hridhayesh09/rv32im-core/docs/results/board_2026-11-11.md

# Board run, 2026-11-11: CoreMark and the SDRAM burst fix

DE10-Lite, 50 MHz. Core with the default branch predictor (32-entry BTB, gshare with 256 counters,
4-entry return stack). CoreMark 1.0 from EEMBC (third_party/coremark), 2K performance run, port in
`sw/coremark`, GCC 13.2.0 `-O2 -ffreestanding -march=rv32im_zicsr_zifencei -mabi=ilp32`. Time is the
cycle counter; CoreMark picked 2000 iterations (over 10 s, so the runs are valid).

## CoreMark

| Build and placement | Iterations | Timed cycles | Time | CoreMark/MHz | CoreMark at 50 MHz | CPI | Mispredicted branches |
|---|---|---|---|---|---|---|---|
| Full SoC (NPU, no caches), program in on-chip RAM | 2000 | 741,126,904 | 14.82 s | **2.699** | 134.9 | 1.177 | 12.8 % |
| CPU-only (4 KB I$ + D$), program in on-chip RAM | 2000 | 741,126,904 | 14.82 s | **2.699** | 134.9 | 1.177 | 12.8 % |
| CPU-only (4 KB I$ + D$), program in SDRAM through the caches | 2000 | 751,703,684 | 15.03 s | **2.661** | 133.0 | 1.194 | 12.8 % |

CoreMark/MHz = iterations x 10^6 / cycles. CoreMark's own "Iterations/Sec" line divides by whole
seconds, so it rounds (142 and 133 instead of 134.9 and 133.0).

The two RAM runs took exactly the same number of cycles: the NPU and the caches don't touch a
program in on-chip RAM. From SDRAM, the 4 KB caches cost 1.4 % (10,576,780 cycles).

## SDRAM burst reads: found and fixed on the board

The first run of the cached build failed: the bootloader's LOAD of CoreMark into SDRAM was
rejected (`ERR crc`), and `sdram_test.bin` failed address lines, random words, bytes and copy
(simulation passed). The cached build moves 16-byte lines; the board had only ever run the
single-word path before.

1. The fitter report showed `DRAM_DQ[*]` with no input register in the I/O cell and a
   combinational fan-out of 8: each pin went straight into the 8-slot burst buffer, so the
   capture time depended on routing.
2. With a rising-edge I/O input register (`FAST_INPUT_REGISTER`) at 60 ns after READ:
   still failing, now everywhere.
3. A new diagnostic (`sw/soc/sdram_diag.c`, using a new uncached SDRAM window at 0x5000_0000)
   split the paths. Single words read back as their upper halfword twice (`9f379f37` for
   `9f3778b0`), and line reads returned correct halfwords shifted by one: writes were fine, reads
   were captured one cycle late.
4. Fix: the I/O input register clocked on the falling edge, 50 ns after READ, the middle of the
   window measured with edge-ml-accelerator/boardtest (clean from 50 to 70 ns). After that:

```
SDRAM diag
1 words: uncached write, uncached read: 0 errors
2 burst reads: uncached write, cached read: 0 errors
3 burst writes: cached write, uncached read: 0 errors
4 both: cached write, evict, cached read: 0 errors
DIAG PASS
```
```
SDRAM test
address lines: ok
random words: ok
bytes and halfwords: ok
copy: ok, write 2781 cycles, read 1318 cycles for 256 words
SDRAM PASS
```

## Full SoC after the fix (NPU, no caches; SDRAM over single-word accesses)

`sdram_test.bin`: `SDRAM PASS` (copy: write 2618 cycles, read 3648 cycles for 256 words).
The full-SoC CoreMark row above was measured again on this bitstream: 741,126,904 cycles, the same.

MNIST, the same 200 test images as on 2026-11-07 (`python tools/export_mnist.py 200`):

| | 2026-11-07 | 2026-11-11 (memory access from EX, branch predictor) |
|---|---|---|
| Software, cycles per image | 856,963 | 847,536 |
| NPU, cycles per image | 22,263 | 21,172 |
| Speedup | 38.49x | 40.03x |
| NPU correct | 199 / 200 | 199 / 200, all logits bit-exact |

```
build/mnist/mnist_blob.bin -> 0x40000000: sending 216896 bytes (18.8 s at 115200 baud)
build/sw/mnist.bin: sending 6688 bytes (0.6 s at 115200 baud)
board: OK, program running
starting program
MNIST on rv32im-core
software: 10 images, 10/10 correct, 847536 cycles per image (16950 us)
NPU:      200 images, 199/200 correct, 21172 cycles per image (423 us)
speedup: 40.03x
MNIST PASS: all logits bit-exact
DONE
```

## Doom

CPU-only build with the 8-bit VGA mode (320x200, 256 colours), 4 KB caches, the default branch
predictor: 14,059 LEs, 149 / 182 M9K, 55.11 MHz (slow 85C). doomgeneric + picolibc, GCC -O2,
everything in SDRAM; Freedoom Phase 1 (`freedoom1.wad`, 28,795,076 bytes) uploaded at 2 Mbaud
(`--fast 2000000`, 144 s). No sound.

Doom's own benchmark, `-timedemo demo1` (SW0 up): every game tic is drawn, as fast as possible.

```
timed 7117 gametics in 21254 realtics (11.719912 fps)
```

**11.7 frames per second** over the whole demo (607 s). The 5-second windows printed while it ran
ranged from 7.4 to 14.7 fps (116 windows after start-up).

```
switch to 2000000 baud: sending 0 bytes (0.0 s at 115200 baud)
build/sw/doom.bin -> 0x40000000: sending 406384 bytes (2.0 s at 2000000 baud)
build/doom/freedoom1.wad -> 0x42000000: sending 28795076 bytes (144.0 s at 2000000 baud)
build/sw/jump_to_sdram.bin: sending 8 bytes (0.0 s at 2000000 baud)
board: OK, program running
starting program
Doom on rv32im-core
WAD: 28795076 bytes, playing as freedoom1.wad
                           Doom Generic 0.1
Z_Init: Init zone memory allocation daemon. 
zone memory: 0x40449248, 600000 allocated for zone
Using . for configuration and saves
V_Init: allocate screens.
M_LoadDefaults: Load system defaults.
saving config in .default.cfg
W_Init: Init WADfiles.
 adding freedoom1.wad
 adding demo1.lmp
 couldn't open demo1.lmp
Playing demo demo1.lmp.
Using ./.savegame/ for savegames
===========================================================================
                           Freedoom: Phase 1
===========================================================================
 Doom Generic is free software, covered by the GNU General Public
 License.  There is NO warranty; not even for MERCHANTABILITY or FITNESS
 FOR A PARTICULAR PURPOSE. You are welcome to change and distribute
 copies under certain conditions. See the source for more information.
===========================================================================
 WARNING: You are playing using one of the Freedoom IWAD
 files, which might not work in this port. See this page
 for more information on how to play using Freedoom:
   http://www.chocolate-doom.org/wiki/index.php/Freedoom
===========================================================================
I_Init: Setting up machine state.
M_Init: Init miscellaneous info.
R_Init: Init DOOM refresh daemon - .......................................
P_Init: Init Playloop state.
S_Init: Setting up sound.
D_CheckNetGame: Checking network game status.
startskill 2  deathmatch: 0  startmap: 1  startepisode: 1
player 1 of 1 (1 nodes)
Emulating the behavior of the 'Ultimate Doom' executable.
HU_Init: Setting up heads up display.
ST_Init: Init status bar.
Freedoom: Phase 1
I_InitGraphics: framebuffer: x_res: 320, y_res: 200, x_virtual: 320, y_virtual: 200, bpp: 8
I_InitGraphics: framebuffer: RGBA: 0000, red_off: 0, green_off: 0, blue_off: 0, transp_off: 0
I_InitGraphics: DOOM screen size: w x h: 320 x 200
I_InitGraphics: Auto-scaling factor: 1
1 frames in 23468 ms: 0.0 fps
44 frames in 5052 ms: 8.7 fps
43 frames in 5055 ms: 8.5 fps
44 frames in 5023 ms: 8.7 fps
45 frames in 5058 ms: 8.8 fps
45 frames in 5058 ms: 8.8 fps
44 frames in 5028 ms: 8.7 fps
45 frames in 5026 ms: 8.9 fps
53 frames in 5066 ms: 10.4 fps
49 frames in 5059 ms: 9.6 fps
58 frames in 5030 ms: 11.5 fps
54 frames in 5013 ms: 10.7 fps
62 frames in 5048 ms: 12.2 fps
50 frames in 5067 ms: 9.8 fps
54 frames in 5000 ms: 10.8 fps
70 frames in 5065 ms: 13.8 fps
64 frames in 5067 ms: 12.6 fps
59 frames in 5102 ms: 11.5 fps
62 frames in 5024 ms: 12.3 fps
65 frames in 5069 ms: 12.8 fps
48 frames in 5045 ms: 9.5 fps
43 frames in 5109 ms: 8.4 fps
56 frames in 5056 ms: 11.0 fps
69 frames in 5079 ms: 13.5 fps
46 frames in 5021 ms: 9.1 fps
55 frames in 5088 ms: 10.8 fps
60 frames in 5013 ms: 11.9 fps
63 frames in 5000 ms: 12.6 fps
58 frames in 5040 ms: 11.5 fps
63 frames in 5056 ms: 12.4 fps
67 frames in 5052 ms: 13.2 fps
57 frames in 5069 ms: 11.2 fps
61 frames in 5060 ms: 12.0 fps
54 frames in 5001 ms: 10.7 fps
60 frames in 5003 ms: 11.9 fps
59 frames in 5032 ms: 11.7 fps
51 frames in 5047 ms: 10.1 fps
60 frames in 5028 ms: 11.9 fps
60 frames in 5012 ms: 11.9 fps
57 frames in 5074 ms: 11.2 fps
63 frames in 5034 ms: 12.5 fps
61 frames in 5063 ms: 12.0 fps
59 frames in 5023 ms: 11.7 fps
59 frames in 5059 ms: 11.6 fps
63 frames in 5079 ms: 12.4 fps
62 frames in 5028 ms: 12.3 fps
66 frames in 5070 ms: 13.0 fps
62 frames in 5003 ms: 12.3 fps
68 frames in 5002 ms: 13.5 fps
66 frames in 5040 ms: 13.0 fps
59 frames in 5044 ms: 11.6 fps
61 frames in 5065 ms: 12.0 fps
62 frames in 5066 ms: 12.2 fps
68 frames in 5069 ms: 13.4 fps
68 frames in 5069 ms: 13.4 fps
66 frames in 5007 ms: 13.1 fps
60 frames in 5025 ms: 11.9 fps
61 frames in 5064 ms: 12.0 fps
65 frames in 5033 ms: 12.9 fps
64 frames in 5002 ms: 12.7 fps
69 frames in 5026 ms: 13.7 fps
60 frames in 5013 ms: 11.9 fps
60 frames in 5041 ms: 11.9 fps
62 frames in 5052 ms: 12.2 fps
64 frames in 5065 ms: 12.6 fps
61 frames in 5005 ms: 12.1 fps
65 frames in 5049 ms: 12.8 fps
65 frames in 5026 ms: 12.9 fps
65 frames in 5050 ms: 12.8 fps
70 frames in 5000 ms: 14.0 fps
70 frames in 5044 ms: 13.8 fps
71 frames in 5054 ms: 14.0 fps
71 frames in 5039 ms: 14.0 fps
58 frames in 5012 ms: 11.5 fps
64 frames in 5001 ms: 12.7 fps
68 frames in 5040 ms: 13.4 fps
74 frames in 5033 ms: 14.7 fps
68 frames in 5097 ms: 13.3 fps
42 frames in 5026 ms: 8.3 fps
61 frames in 5071 ms: 12.0 fps
57 frames in 5038 ms: 11.3 fps
42 frames in 5073 ms: 8.2 fps
67 frames in 5048 ms: 13.2 fps
38 frames in 5096 ms: 7.4 fps
44 frames in 5055 ms: 8.7 fps
68 frames in 5037 ms: 13.5 fps
64 frames in 5041 ms: 12.6 fps
55 frames in 5056 ms: 10.8 fps
64 frames in 5018 ms: 12.7 fps
67 frames in 5072 ms: 13.2 fps
64 frames in 5009 ms: 12.7 fps
60 frames in 5039 ms: 11.9 fps
63 frames in 5039 ms: 12.5 fps
59 frames in 5023 ms: 11.7 fps
53 frames in 5091 ms: 10.4 fps
56 frames in 5069 ms: 11.0 fps
58 frames in 5058 ms: 11.4 fps
58 frames in 5054 ms: 11.4 fps
64 frames in 5006 ms: 12.7 fps
66 frames in 5046 ms: 13.0 fps
65 frames in 5069 ms: 12.8 fps
64 frames in 5030 ms: 12.7 fps
62 frames in 5063 ms: 12.2 fps
65 frames in 5030 ms: 12.9 fps
51 frames in 5027 ms: 10.1 fps
53 frames in 5043 ms: 10.5 fps
48 frames in 5015 ms: 9.5 fps
55 frames in 5077 ms: 10.8 fps
52 frames in 5020 ms: 10.3 fps
58 frames in 5052 ms: 11.4 fps
72 frames in 5061 ms: 14.2 fps
67 frames in 5008 ms: 13.3 fps
58 frames in 5020 ms: 11.5 fps
61 frames in 5023 ms: 12.1 fps
63 frames in 5021 ms: 12.5 fps
68 frames in 5035 ms: 13.5 fps
61 frames in 5016 ms: 12.1 fps
timed 7117 gametics in 21254 realtics (11.719912 fps)
Doom exited (-1)
DONE
```

### Playing

With SW0 down Doom starts normally; `tools/doom_keys.py` sent the laptop's key presses over the
serial port (2 Mbaud), and the game was played on the VGA monitor: menus, a new game, moving,
firing and opening doors all respond.

## Raw CoreMark output

Full SoC, on-chip RAM:
```
build/sw/coremark_ram.bin: sending 12836 bytes (1.1 s at 115200 baud)
board: OK, program running
starting program
2K performance run parameters for coremark.
CoreMark Size    : 666
Total ticks      : 741126904
Total time (secs): 14
Iterations/Sec   : 142
Iterations       : 2000
Compiler version : GCC13.2.0
Compiler flags   : -O2 -ffreestanding -march=rv32im_zicsr_zifencei -mabi=ilp32
Memory location  : on-chip RAM
seedcrc          : 0xe9f5
[0]crclist       : 0xe714
[0]crcmatrix     : 0x1fd7
[0]crcstate      : 0x8e3a
[0]crcfinal      : 0x4983
Correct operation validated. See README.md for run and reporting rules.
Timed cycles     : 741126904
Timed instret    : 629675770
Timed branches   : 129600633
Timed mispredicts: 16604473
COREMARK DONE
```
CPU-only, on-chip RAM:
```
build/sw/coremark_ram.bin: sending 12836 bytes (1.1 s at 115200 baud)
board: OK, program running
starting program
2K performance run parameters for coremark.
CoreMark Size    : 666
Total ticks      : 741126904
Total time (secs): 14
Iterations/Sec   : 142
Iterations       : 2000
Compiler version : GCC13.2.0
Compiler flags   : -O2 -ffreestanding -march=rv32im_zicsr_zifencei -mabi=ilp32
Memory location  : on-chip RAM
seedcrc          : 0xe9f5
[0]crclist       : 0xe714
[0]crcmatrix     : 0x1fd7
[0]crcstate      : 0x8e3a
[0]crcfinal      : 0x4983
Correct operation validated. See README.md for run and reporting rules.
Timed cycles     : 741126904
Timed instret    : 629675770
Timed branches   : 129600633
Timed mispredicts: 16604473
COREMARK DONE
```
CPU-only, SDRAM through the caches:
```
build/sw/coremark_sdram.bin -> 0x40000000: sending 12844 bytes (1.1 s at 115200 baud)
build/sw/jump_to_sdram.bin: sending 8 bytes (0.0 s at 115200 baud)
board: OK, program running
starting program
2K performance run parameters for coremark.
CoreMark Size    : 666
Total ticks      : 751703684
Total time (secs): 15
Iterations/Sec   : 133
Iterations       : 2000
Compiler version : GCC13.2.0
Compiler flags   : -O2 -ffreestanding -march=rv32im_zicsr_zifencei -mabi=ilp32
Memory location  : SDRAM via caches
seedcrc          : 0xe9f5
[0]crclist       : 0xe714
[0]crcmatrix     : 0x1fd7
[0]crcstate      : 0x8e3a
[0]crcfinal      : 0x4983
Correct operation validated. See README.md for run and reporting rules.
Timed cycles     : 751703684
Timed instret    : 629675770
Timed branches   : 129600633
Timed mispredicts: 16604473
COREMARK DONE
```
