hridhayesh09/rv32im-core/docs/results/board_2026-11-07.md

# Board results, 2026-11-07

DE10-Lite (10M50DAF484C7G), 50 MHz, FPGA image from fpga/de10lite (Quartus Prime Lite 25.1:
31,762 LEs, 165/182 M9K, 136 multipliers, +2.103 ns setup slack at 50 MHz). UART through the
ESP32-S3's CH343 USB-serial chip (ESP32 held in reset) on COM8, 115200 baud. Commands from
docs/board_bringup.md; output copied as printed, except that the hello log's doubled blank
lines (a display bug in the first version of upload.py on Windows, since fixed) are removed.

## Bootloader banner (after programming the FPGA)

```
rv32im-core bootloader
ready
```

## tools/upload.py COM8 build/sw/hello.bin --until DONE

```
sending 3808 bytes (0.3 s at 115200 baud)
board: OK, program running
starting program
Hello from rv32im-core!
fib(30) = 832040, 233 cycles
switches = 0x3ff
printf check: [  -42] [  7] [0000beef] [ok] [Z] [%]
DONE

```

## tools/upload.py COM8 build/sw/sdram_test.bin --until DONE

```
sending 4600 bytes (0.4 s at 115200 baud)
board: OK, program running

starting program
SDRAM test
address lines: ok
random words: ok
bytes and halfwords: ok
copy: ok, write 3109 cycles, read 3907 cycles for 256 words
SDRAM PASS
DONE
```

## tools/upload.py COM8 build/sw/mnist.bin --data 0x40000000 build/mnist/mnist_blob.bin --until DONE

```
C:\Users\hridh\rv32im-core\build\mnist\mnist_blob.bin -> 0x40000000: sending 216896 bytes (18.8 s at 115200 baud)
C:\Users\hridh\rv32im-core\build\sw\mnist.bin: sending 6624 bytes (0.6 s at 115200 baud)
board: OK, program running

starting program
MNIST on rv32im-core
software: 10 images, 10/10 correct, 856963 cycles per image (17139 us)
NPU:      200 images, 199/200 correct, 22263 cycles per image (445 us)
speedup: 38.49x
MNIST PASS: all logits bit-exact
DONE
```

## VGA and Snake, 2026-11-10

Same FPGA image, VGA monitor on the DE10-Lite's VGA connector. `tools/upload.py COM8 build/sw/snake.bin`:

```
C:\Users\hridh\rv32im-core\build\sw\snake.bin: sending 6140 bytes (0.5 s at 115200 baud)
board: OK, program running

starting program
SNAKE ready
```

On the monitor: the SNAKE title screen (checked by eye; first time the VGA output was seen on a
real monitor). Then played: KEY0/KEY1 steer the snake, the score updates on the monitor and the
7-segment displays, game over and restart work.
