hridhayesh09/rv32im-core/docs/results/quartus_sweep_2026-11-11.csv

config | LEs | M9K | Fmax_MHz | setup_slack_ns
nobp | 12402 | 147 | 54.06 | 1.502
bimodal | 13597 | 149 | 54.04 | 1.495
gshare | 13701 | 149 | 50.4 | 0.157
gshare-ras | 14059 | 149 | 55.11 | 1.854
btb16 | 13949 | 149 | 54.25 | 1.568
btb64 | 14070 | 149 | 52.85 | 1.079
bht1k | 16514 | 149 | 55.37 | 1.940
1k-dm | 12111 | 149 | 53.81 | 1.417
2k-dm | 12815 | 149 | 54.0 | 1.483
8k-dm | 16635 | 158 | 54.49 | 1.648
1k-2way | 12646 | 159 | 51.86 | 0.718
4k-2way | 14928 | 159 | 49.34 | -0.269
