hridhayesh09/rv32im-core/tb/tb_top.sv

// Simulation top: the core with one dual-port RAM for code and data (as in the SoC), loaded
// from a program image (+program=<hex file>). The retire trace is brought out as ports.
//
// +random_stalls makes data accesses take a random number of extra cycles (like a slow bus
// device), to test the core's wait-state handling with every program.
// The branch predictor configuration is a parameter (defaults: the core's).
module tb_top #(
    parameter int BP_MODE   = 2,
    parameter int BTB_BITS  = 5,
    parameter int BHT_BITS  = 8,
    parameter int RAS_DEPTH = 4
) (
    input  logic        clk,
    input  logic        rst,
    output logic        rvfi_valid,
    output logic [31:0] rvfi_pc,
    output logic [31:0] rvfi_insn,
    output logic [4:0]  rvfi_rd,
    output logic [31:0] rvfi_rd_wdata,
    output logic        rvfi_mem_read,
    output logic [3:0]  rvfi_mem_wmask,
    output logic [31:0] rvfi_mem_addr,
    output logic [31:0] rvfi_mem_wdata
);
    logic        imem_en, dmem_en, dmem_stall;
    logic [3:0]  mem_events;
    logic        imem_stall, fetch_valid, cache_flush;
    assign mem_events = 4'b0000;   // no caches here
    assign imem_stall = 1'b0;
    /* verilator lint_off UNUSEDSIGNAL */
    logic unused_core_outputs;
    assign unused_core_outputs = fetch_valid ^ cache_flush;
    /* verilator lint_on UNUSEDSIGNAL */
    logic [3:0]  dmem_we;
    logic [31:0] imem_addr, imem_rdata, dmem_addr, dmem_wdata, dmem_rdata;

    core #(.BP_MODE(BP_MODE), .BTB_BITS(BTB_BITS), .BHT_BITS(BHT_BITS), .RAS_DEPTH(RAS_DEPTH))
        u_core (.*);

    dpram #(.INIT_PLUSARG("program")) u_ram (
        .clk     (clk),
        .a_en    (imem_en),
        .a_addr  (imem_addr),
        .a_rdata (imem_rdata),
        .b_en    (dmem_en),
        .b_we    (dmem_we),
        .b_addr  (dmem_addr),
        .b_wdata (dmem_wdata),
        .b_rdata (dmem_rdata)
    );

    // Random wait states. `pending`: a data access was sent and its instruction is now in WB.
    // While it is pending, each cycle a pseudo-random bit decides whether the data is late.
    // The RAM isn't enabled during a stall, so its output holds the right data.
    logic        random_stalls, pending;
    logic [15:0] lfsr;

    initial random_stalls = $test$plusargs("random_stalls");

    always_ff @(posedge clk) begin
        if (rst) begin
            pending <= 1'b0;
            lfsr    <= 16'hACE1;
        end else begin
            if (!dmem_stall) pending <= dmem_en;
            lfsr <= {lfsr[14:0], lfsr[15] ^ lfsr[13] ^ lfsr[12] ^ lfsr[10]};
        end
    end

    assign dmem_stall = random_stalls && pending && lfsr[0];
endmodule
