hridhayesh09/rv32im-core/rtl/alu.sv

// Arithmetic logic unit: the 10 RV32I integer operations, purely combinational.
// Shifts use only b[4:0], as the ISA specifies.
module alu
    import rv_pkg::*;
(
    input  logic [31:0] a,
    input  logic [31:0] b,
    input  alu_op_t     op,
    output logic [31:0] y
);
    always_comb begin
        case (op)
            ALU_ADD:  y = a + b;
            ALU_SUB:  y = a - b;
            ALU_SLL:  y = a << b[4:0];
            ALU_SLT:  y = {31'b0, $signed(a) < $signed(b)};
            ALU_SLTU: y = {31'b0, a < b};
            ALU_XOR:  y = a ^ b;
            ALU_SRL:  y = a >> b[4:0];
            ALU_SRA:  y = $unsigned($signed(a) >>> b[4:0]);
            ALU_OR:   y = a | b;
            ALU_AND:  y = a & b;
            default:  y = '0;
        endcase
    end
endmodule
