hridhayesh09/rv32im-core/(commit log)

2026-11-06 Stage 0: repo skeleton, setup guide, Verilator+cocotb smoke test, CI
    Adds the roadmap, setup guide and first notes, make check-tools, an 8-bit counter smoke test checked against a Python model every cycle, and a GitHub Actions workflow that builds and caches Verilator v5.036 and Spike.
2026-11-06 Stage 1 step 1: ALU, register file and decoder with cocotb tests
    ALU: 10 RV32I operations, checked on all boundary-value pairs and 20,000 random cases. Register file: x0 hardwired, write-before-read bypass, 20,000 random cycles against a model. Decoder: all RV32I formats, control signals and illegal-instruction detection, checked with a separate Python encoder (20,000 instructions, immediate extremes, 40,000 random/mutated words). Verilator -Wall is clean. Notes explain each block with interview questions.
2026-11-06 Stage 1 step 2: 5-stage pipeline with branch flush, checked in lockstep with Spike
    IF/ID/EX/MEM/WB with synchronous-read memories, branches and jumps resolved in EX with a 2-instruction flush, and a retire trace. Every instruction of each test program is compared with Spike's commit log (PC, instruction, register write, memory access). Three programs (ALU, loads/stores, control flow) space out dependent instructions because forwarding comes next.
    [core.sv, tb_top.sv]
2026-11-06 Stage 1 step 3: forwarding from MEM and WB into EX
    Operands are taken from the newest in-flight producer (MEM, then WB), with the register file bypass covering distance 3. New forwarding.S runs back-to-back dependencies on ALU ops, stores (address and data), loads used two later, branches, JALR, AUIPC and JAL, and checks that writes to x0 are never forwarded; all match Spike.
2026-11-06 Stage 1 step 4: load-use stall
    When the instruction in ID reads the destination of a load in EX, IF and ID hold for one cycle and a bubble enters EX; WB forwarding then supplies the loaded value. New load_use.S covers every load size, rs1/rs2/store/branch/JALR consumers, pointer chasing, and cases that must not stall; all match Spike. Clearer error when Spike never finishes.
    [core.sv]
2026-11-06 Notes on the pipeline, flush, forwarding and load-use stall; roadmap and README status
    Lockstep and branch flush moved into step 2 so every later step is checked against Spike.
2026-11-06 Stage 1 step 6: official riscv-tests rv32ui in lockstep with Spike
    Adds riscv-tests as a submodule and a minimal riscv_test.h (clear registers, report through tohost). 40 of 42 rv32ui tests pass with every retired instruction matching Spike (13,107 instructions). fence_i (needs FENCE.I with split memories) and ma_data (misaligned access) are excluded with the reason shown in test output. The core build and lockstep runner are now shared by all core-level tests.
2026-11-06 Stage 1 step 8: random instruction tests in lockstep with Spike
    Generator of random RV32I programs (random register values, ALU, loads/stores of every size, forward branches and jumps, counted loops, a small hot register set for dense hazards), each checked instruction by instruction against Spike. CI runs 20 seeds (9,296 instructions); a local 300-seed run compared 140,187 instructions with no mismatch.
2026-11-06 Stage 1 step 9: M extension (multiply and divide)
    Multi-cycle muldiv unit: 2-cycle multiply with registered operands, 33-cycle restoring divider with sign fix-up; EX stalls until done. Decoder accepts the M encodings. All 8 rv32um tests pass in lockstep with Spike, plus a directed muldiv.S and M instructions in the random programs (300 seeds: 140,887 instructions, 6,667 multiply/divide). Measured cost: 2 extra cycles per MUL, 33 per DIVU.
    [core.sv, decoder.sv, muldiv.sv, test_decoder.py, test_muldiv.py]
2026-11-06 Stage 1 step 10: C programs, plus README diagram and results
    crt0.S (clear registers, stack, zero .bss, call main, report through tohost) and a linker script with .bss and stack symbols. fib, sort and primes compile with GCC -O2 and pass in lockstep with Spike; the test reports instructions, cycles and CPI (1.152, 1.298 and 6.977). README now has the pipeline diagram and a results table with numbers from make test.
2026-11-06 README: pipeline diagram and Stage 1 results table
    The previous commit's message mentioned these but the README change didn't make it in.
2026-11-06 Stage 2 plan: memory map and design decisions; CI job timeout
2026-11-06 Stage 2 step 1: wait states on the data port
    New dmem_stall input freezes the whole pipeline while the instruction in WB waits for slow data; requests are sent only once, and the muldiv unit holds its result until taken. tb_top can inject random wait states (+random_stalls); all directed, riscv-tests, C and 10 random programs pass in lockstep with them (e.g. sort 38,312 -> 44,377 cycles). 149 tests pass.
2026-11-06 Stage 2 step 2: Wishbone UART, timer and GPIO
    UART (8N1, programmable divisor, 2-flop RX synchronizer, mid-bit sampling, overrun flag), 64-bit cycle timer with compare and CLK_HZ, and GPIO for the DE10-Lite LEDs, switches, buttons and six 7-segment displays. Each is a Wishbone slave with a registered ack, tested with a small Wishbone master in cocotb (7 tests).
2026-11-06 Shared dual-port RAM for code and data; FENCE.I
    dpram replaces the separate instruction/data RAMs (as in the SoC). FENCE.I redirects to PC+4 so instructions fetched before a store to code are refetched. The official fence_i test now passes (41/42 rv32ui); a new directed fence_i.S patches the very next instruction and fails without the flush.
    [core.sv, decoder.sv, dpram.sv, tb_top.sv, test_decoder.py]
2026-11-06 Stage 2 step 3: the SoC
    soc.sv: core, 8 KB boot ROM and 64 KB RAM as tightly coupled dual-port memories, a Wishbone bridge that freezes the core during bus accesses, and an interconnect with UART, timer, GPIO and a default slave. C driver library (UART, printf, timer, 7-segment) and a hello program; the SoC simulation boots from ROM, runs it from RAM and checks the UART text, LEDs and displays.
    [hello.c, soc.sv]
2026-11-06 Stage 2 step 4: SDRAM controller
    Closed-page controller for the IS42S16320 (burst of 2 halfwords per word, CAS 2, auto-precharge, refresh every 380 cycles, full power-up sequence) on the Wishbone bus at 0x4000_0000. A chip model checks every timing/protocol rule; it found a power-up bug (all-zero command register = LOAD MODE), fixed with a NOP power-up value. Unit test: 3,000 random accesses, 0 violations. SoC test: C memory test passes, 256-word copy 2,855 cycles write / 3,615 read.
    [sdram_ctrl.sv, sdram_model.sv, sdram_test.c, soc.sv, tb_sdram.sv, tb_soc.sv, test_sdram.py]
2026-11-06 Stage 2 step 5: UART bootloader
    Boot ROM bootloader (996 bytes): receives BOOT + length + program + CRC-32 into on-chip RAM, checks the CRC, fence.i, and jumps; 'R' reruns the program in RAM. tools/upload.py sends a program and shows its output; make sw builds the boot ROM image and uploadable programs. SoC test: a corrupted upload is rejected with ERR crc, then the real 2,708-byte program runs.
2026-11-06 Stage 2 step 6: DE10-Lite build
    Board top level, pins and SDRAM clocking reused from the board-tested edge-ml-accelerator/boardtest. Fixes found by the first Quartus compile: unsupported SystemVerilog (inside, size casts, a field named like a module), a register file Quartus considered unused, memories not mapped to block RAM (now altsyncram true dual-port for the FPGA, behavioural model in simulation, boot ROM as .mif), and a near-zero timing margin (slave decode now registered). Result: 4,626 LEs (9%), 589,824 memory bits (35%), 8 multipliers, Fmax 55.17 MHz at slow 85C, +1.875 ns setup slack at 50 MHz. Adds the board bring-up checklist and film list.
    [build_sw.py, core.sv, de10lite_top.sv, decoder.sv, dpram.sv, regfile.sv, sdram_ctrl.sv]
2026-11-06 Stage 3 plan: on-chip 320x240 4-bit framebuffer, and its consequence for Stage 4's block RAM budget
2026-11-06 Stage 3 step 1: VGA display with a 320x240, 16-colour framebuffer
    wb_vga: 640x480@60 timing from a 25 MHz pixel enable, framebuffer pixels doubled in both directions, 16-entry programmable palette, vblank status and frame counter. fb_ram: 4-bit true dual-port (altsyncram on the FPGA). A simulated monitor (tb/vga_capture.sv) locks onto the sync pulses, checks every timing number and saves frames as PPM; tools/ppm.py converts to PNG. Unit test: written pixels and a palette change appear as the right 2x2 blocks on screen, 0 timing errors.
    [fb_ram.sv, ppm.py, sim.py, tb_vga.sv, test_vga.py, vga_capture.sv, wb_vga.sv]
2026-11-06 Stage 3 steps 2-4: VGA in the SoC, graphics driver, Snake
    The VGA block is on the bus (registers at 0x1000_3000, framebuffer at 0x2000_0000) and the SoC simulation includes the simulated monitor. sw/lib/gfx.c: pixels, rectangles, 5x7 text, palette, vblank wait. sw/soc/snake.c: Snake with KEY0/KEY1 or W/A/S/D, score on screen, 7-segment and UART. The SoC test plays a game (start, turn, crash), checks every move and the captured picture; screenshots in docs/images from those runs. 163 tests pass.
    [snake.c, soc.sv, tb_soc.sv]
2026-11-06 Stage 3 step 5: VGA on the DE10-Lite build, board checklist and film list
    VGA pins from the boardtest pin list. Quartus: 5,197 LEs (10%), 110/182 M9K (72 SoC + 38 framebuffer, as planned), Fmax 52.63 MHz at slow 85C, +1.001 ns setup slack at 50 MHz. README shows the Snake screenshot from simulation.
2026-11-06 Stage 4 plan: memory-mapped NPU with local buffers, weights in SDRAM, block RAM and DSP budget
2026-11-06 Stage 4 step 1: NPU block around the 16x16 systolic array
    wb_npu: weight tile loading (one PE row per 4 writes), a 1024-row activation buffer and a 256-row int32 result buffer (simple dual-port M9K style from edge-ml-accelerator), and a sequencer that streams COUNT rows at one per clock with base/stride addressing and an accumulate mode. systolic_array.v and pe.v copied unchanged from edge-ml-accelerator. Unit tests against NumPy: one tile with extreme values, K accumulation over 3 tiles, 6 random products; 20 rows take 52 cycles.
2026-11-07 Stage 4 steps 2-4: NPU in the SoC, MNIST software vs NPU (bit-exact)
    NPU on the bus (registers 0x1000_4000, buffers 0x3000_0000). Model + 200 test images in sw/mnist (from edge-ml-accelerator), tools/export_mnist.py packs them with NumPy reference logits for SDRAM; the SDRAM model can preload it in simulation. sw/soc/mnist.c runs the network in software and on the NPU and checks every logit. Simulation: software 700,853 cycles/image, NPU 22,179, speedup 31.59x, all bit-exact. First full Quartus fit with the 16x16 array: 31,903 LEs (64%), 165/182 M9K, 136 multipliers, but -0.127 ns setup slack; bus read data and the stall are now registered in the bridge to fix that (Quartus not rerun yet).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
    [export_mnist.py, make_mnist_data.py, mnist.c, sdram_model.sv, soc.sv]
2026-11-07 First board run: bootloader, SDRAM and MNIST on the DE10-Lite
    On the board: bootloader banner, hello, the 64 MB SDRAM test, and MNIST with the model in SDRAM: software 856,963 cycles/image, NPU 22,263 (38.49x), 199/200 correct, every logit bit-exact with NumPy. Logs in docs/results/board_2026-11-07.md. Bootloader LOAD command (data to SDRAM or free RAM) with a simulation test; the bootloader waits for SDRAM init before 'ready' so LOAD can't lose bytes. upload.py --data and Windows line endings. Timing with the NPU: +2.103 ns at 50 MHz after registering bus read data. 166 tests pass.
    [bootloader.c, loadcheck.c, upload.py]
2026-11-11 Fix a code fence in the board log
2026-11-11 Snake played on the board: buttons, VGA and 7-segment score work
2026-11-11 Roadmap: Stage 5 (exceptions, counters, caches, branch prediction, CoreMark), Doom, Stage 6 (OpenLane)
2026-11-11 Stage 5 step 1: exceptions and CSRs; rv32ui 42/42
    Machine-mode CSRs (mstatus, misa, mie/mip, mtvec, mscratch, mepc, mcause, mtval, mcycle, minstret and the read-only aliases), the six CSR instructions and MRET. Precise exceptions taken in EX for illegal instructions, ECALL, EBREAK and misaligned loads, stores and jump targets. minstret reads include the older instructions still in MEM/WB so values match Spike. The riscv-tests environment emulates misaligned accesses in a trap handler, so ma_data passes (8,393 instructions in lockstep with Spike, run with --priv=m). New directed traps.S. 170 tests pass, none skipped.
    [core.sv, csr.sv, decoder.sv, soc.sv]
2026-11-11 Stage 5 step 2: performance counters
    mhpmcounter3-11 (and read-only hpmcounter copies): branches, mispredicts, load-use stall cycles, mul/div wait, memory wait, and four inputs for cache accesses/misses. sw/lib/perf.h reads them from C (with a memory clobber). perf_test.c checks exact counts in the SoC simulation: 100 branches / 99 mispredicts, 50 load-use stalls, 33 cycles per divide, 2 per multiply, 2 per bus read. 171 tests pass.
    [core.sv, csr.sv, perf_test.c, soc.sv, tb_top.sv]
2026-11-11 SoC: mark the SDRAM line port outputs as intentionally unconnected (fixes the SoC build)
    [soc.sv]
2026-11-11 Stage 5 steps 3-5: instruction and data caches
    cache.sv: direct-mapped or 2-way LRU, 16-byte lines, block-RAM tags/data with flip-flop valid/dirty/LRU bits, same hit timing as plain block RAM; misses freeze the pipeline while a dirty victim is written back, the line refilled and the lookup replayed. Data cache is write-back, write-allocate, with store forwarding (also into victim lines). FENCE.I writes back the D-cache and invalidates the I-cache. Core: imem_stall, fetch_valid, cache_flush; cache events feed mhpmcounter8-11. tb_cached runs every lockstep test through 256-byte DM and 2-way caches with random memory latency: 142 runs match Spike. Planted bugs caught. 314 tests pass.
    [cache.sv, cache_ram.sv, core.sv, line_mem.sv, mem_arbiter.sv, soc.sv, tb_cached.sv, tb_top.sv]
2026-11-11 Caches in the SoC, CPU-only build, and an earlier memory stage for timing
    - soc.sv: optional I-cache and D-cache in front of SDRAM (0x4xxxxxxx), sharing
    the SDRAM line port through the arbiter; NPU can be left out.
    - rv32im_cpu revision: CPU-only build with 4 KB caches.
    - core.sv: loads and stores are sent from EX (address straight from the ALU),
    and the loaded value is aligned and registered in MEM, so WB forwards only
    registered values. CPU-only build: 46.91 -> 55.63 MHz; full build with NPU:
    55.88 -> 56.76 MHz.
    - cache_test.c runs from SDRAM through the caches; tests for it and the counters.
2026-11-11 CoreMark on the board, and SDRAM burst reads fixed on hardware
    - CoreMark 1.0 (EEMBC, submodule) with a port in sw/coremark: 2.699
    CoreMark/MHz from on-chip RAM, 2.661 from SDRAM through 4 KB caches
    (2000 iterations, ~15 s, validated); simulation test checks the CRCs.
    - SDRAM: the cached build's line reads failed on the board. Read data is now
    captured by a falling-edge register in the I/O cell, 50 ns after READ (the
    middle of the window measured with boardtest). Uncached SDRAM window at
    0x5000_0000 and sw/soc/sdram_diag.c to test words, burst reads and burst
    writes separately.
    - MNIST rerun on the board: 40.03x (software 847,536 cycles, NPU 21,172).
    - Cache and predictor paramet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
    [build_sw.py, coremark_sweep.py, de10lite_top.sv, export_mnist.py, quartus_sweep.py]
2026-11-11 Doom runs on the board: 11.7 fps in the timedemo
    - doomgeneric (submodule) with picolibc: sw/doom provides the platform layer
    (frame, clock, keys) and the system calls; the WAD is read from SDRAM.
    tools/build_doom.py builds it with picolibc's start-up code and linker script.
    - VGA 8-bit mode for the CPU-only build: 320x200, 256-entry palette, 32-bit
    writes into a simple dual-port framebuffer (fb8_ram), shown with black bars.
    - UART: 64-byte receive FIFO. Bootloader: BAUD command (2 Mbaud uploads) and a
    table CRC. upload.py --fast, tools/doom_keys.py for keyboard input.
    - Freedoom Phase 1, -timedemo demo1 on the DE10-Lite: 7117 tics in 607 s,
    11.7 fps. CPU-only build: 14,059 LEs, 14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
2026-11-11 Doom: keyboard play tested on the board
2026-11-11 Stage 6 ready to run: ASIC top level, OpenLane 2 flow, gate-level test
    - rtl/rv32im_asic.sv: core + 256-byte I$/D$ + arbiter, one line port and the
    retire trace. tb_cached is now this module plus the line memory, so all
    cached lockstep tests run on exactly what goes into the flow.
    - cache_ram.sv: flip-flop RAM when ASIC is defined (block RAM on the FPGA).
    - asic/run_flow.sh (sv2v, then OpenLane 2, Sky130A, 20 ns), asic/config.json,
    tools/asic_report.py, tests/core/test_gate_level.py (riscv-tests on the
    final netlist in Icarus, skipped until a netlist exists), docs/asic.md.
    - quartus_sweep.py: start every build from an empty Quartus database (it was
    reusing a stale branch predictor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
    [asic_report.py, cache_ram.sv, quartus_sweep.py, rv32im_asic.sv, tb_asic_gl.sv, tb_cached.sv, test_asic_lint.py]
2026-11-11 Stage 5 tradeoff table: Quartus cost of each cache and predictor configuration against CoreMark
    [quartus_sweep_2026-11-11.csv]
2026-11-11 Full SoC rebuilt with the UART FIFO and new bootloader: checked on the board (SDRAM, MNIST at 2 Mbaud)
2026-11-11 Stage 6: the core as a Sky130 layout, DRC/LVS clean, gate-level tested
    - OpenLane 2.3.10 on Sky130A (sky130_fd_sc_hd): rv32im_asic (core, branch
    predictor, 256-byte I$/D$) to GDS. 1.82 mm2 die, 95,916 instances.
    Magic/KLayout DRC 0, LVS 0. Setup slack at 20 ns: +5.49 ns typical
    (68.9 MHz), -7.81 ns slow corner (36.0 MHz). 153 antenna violations remain.
    - Gate-level: all 50 riscv-tests on the final netlist match Spike (24,360
    instructions, Icarus with Sky130 cell models).
    - Flow fixes: sv2v before Yosys (Synlig crashed); branch predictor counters
    and cache arrays as packed vectors (OpenLane lint, Yosys array support);
    line_mem without an automatic variable (Icarus). Same cycle cou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
    [bpred.sv, cache.sv, layout_png.py, line_mem.sv]
2026-11-12 Fix minstreth writes; shorten the slowest ASIC paths
    - csr.sv: writing minstreth lost the counts of the two older instructions still
    in the pipeline (it used the low-half correction). Found by a new lockstep
    test in traps.S (read right after a write, load in flight, high half,
    set/clear forms); a planted bug confirms the test.
    - minstret writes now take two cycles (stored, then corrected from registered
    values) and flush the younger instructions like FENCE.I: the write was the
    slowest path in the Sky130 flow (-7.8 ns at the slow corner).
    - The late flush signal only clears the valid bit of the IF/ID and ID/EX
    registers instead of gating every field (the mispredict path, -4.1 ns).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
    [core.sv, csr.sv]
2026-11-12 Chip layout rerun: antenna violations 153 -> 29, slow corner 36 -> 41.7 MHz
    - OpenLane with diode insertion and post-route timing repair, on the RTL with
    the two-cycle minstret write and the valid-only flush.
    - DRC 0 (Magic and KLayout), LVS 0; typical corner 77.9 MHz, slow corner
    41.7 MHz (worst extraction 39.9 MHz); 1.83 mm2, 146,809 instances, 135 mW.
    - Gate-level: all 50 riscv-tests on the new netlist match Spike (24,360
    instructions).
    - Remaining: 29 antenna nets, max slew/cap/fanout warnings (grew with the
    inserted diodes and buffers), 50 MHz not met at the slow corner.
